ColumbiaGadgetWorks/radio-hardware/kicad/jlcpcb/BOM.csv

Comment | Designator | Footprint | LCSC Part # | MPN | Qty
22pF | C1,C2 | C_0603_1608Metric | C1653 | CL10C220JB8NNNC | 2
10uF | C13,C15,C16,C17,C18 | C_0603_1608Metric | C19702 | CL10A106KP8NNNC | 5
4.7uF | C3 | C_0603_1608Metric | C19666 | CL10A475KO8NNNC | 1
100nF | C4,C5,C6,C11,C14,C22 | C_0603_1608Metric | C14663 | CC0603KRX7R9BB104 | 6
22uF | C7,C21 | C_0603_1608Metric | C59461 | CL10A226MQ8NRNC | 2
1uF | C8,C10,C12,C19,C20 | C_0603_1608Metric | C15849 | CL10A105KB8NNNC | 5
1nF | C9 | C_0603_1608Metric | C1588 | CL10B102KB8NNNC | 1
B5819W | D1 | D_SOD-123 | C8598 | B5819W SL | 1
RED charging | D2 | LED_0603_1608Metric | C2286 | KT-0603R | 1
GREEN full | D3 | LED_0805_2012Metric | C2297 | KT-0805G | 1
0R (PTC spot) | F1 | Fuse_1206_3216Metric | C17888 | 1206W4F0000T5E | 1
USB-C 5V | J1 | USB_C_Receptacle_ShouHan_TYPE-C-6P-LTH6.8-108_Vertical | C30167335 | TYPE-C 6P LTH6.8 108 | 1
BATT PH2.0 | J2 | Battery_PH2.0_RightAngle_SMD_PlugCutout | C7429689 | ZX-PH2.0-WT2P | 1
56nH | L1 | L_0603_1608Metric | C98080 | LQW18AN56NJ00D | 1
AO3401A | Q1 | SOT-23 | C15127 | AO3401A | 1
100k | R1,R16,R17 | R_0603_1608Metric | C25803 | 0603WAF1003T5E | 3
5.1k | R11,R12 | R_0603_1608Metric | C23186 | 0603WAF5101T5E | 2
2.4k | R13 | R_0603_1608Metric | C22940 | 0603WAF2401T5E | 1
680R | R14 | R_0603_1608Metric | C23228 | 0603WAF6800T5E | 1
1k | R15,R18 | R_0603_1608Metric | C21190 | 0603WAF1001T5E | 2
51k | R2 | R_0603_1608Metric | C23196 | 0603WAF5102T5E | 1
4.7k | R22 | R_0603_1608Metric | C23162 | 0603WAF4701T5E | 1
0R (pin1 = -) | R23 | R_1206_3216Metric | C17888 | 1206W4F0000T5E | 1
0R (pin2 = +) | R24 | R_1206_3216Metric | C17888 | 1206W4F0000T5E | 1
10k | R3 | R_0603_1608Metric | C25804 | 0603WAF1002T5E | 1
100R | R4 | R_0603_1608Metric | C22775 | 0603WAF1000T5E | 1
330k | R5 | R_0603_1608Metric | C23137 | 0603WAF3303T5E | 1
68k | R6 | R_0603_1608Metric | C23231 | 0603WAF6802T5E | 1
47k | R7 | R_0603_1608Metric | C25819 | 0603WAF4702T5E | 1
680k | R8 | R_0603_1608Metric | C25822 | 0603WAF6803T5E | 1
0R | R9,R21 | R_0603_1608Metric | C21189 | 0603WAF0000T5E | 2
10k A + SW | RV1 | Potentiometer_CTR_R09512NS_RearMount_Switch | C18213422 | R09512NS-FB15S7.0-A103-00G | 1
Si4825-A10 | U1 | SOIC-16_3.9x9.9mm_P1.27mm | C2654605 | SI4825-A10-CSR | 1
NS8002 | U2 | SOIC-8-1EP_3.9x4.9mm_P1.27mm_EP2.41x3.3mm | C189960 | NS8002 | 1
TP4056 | U3 | SOIC-8-1EP_3.9x4.9mm_P1.27mm_EP2.29x3mm | C16581 | TP4056-42-ESOP8 | 1
XC6206P332MR | U4 | SOT-23 | C5446 | XC6206P332MR | 1
XB8089D | U6 | SOIC-8-1EP_3.9x4.9mm_P1.27mm_EP2.41x3.3mm | C79928 | XB8089D | 1
32.768kHz | Y1 | Crystal_SMD_3215-2Pin_3.2x1.5mm | C32346 | Q13FC13500004 | 1
