ColumbiaGadgetWorks/radio-hardware/kicad/scripts/circuit.py

"""The jar radio circuit: one place that defines every part and net.

gen_schematic.py turns this into the .kicad_sch, gen_pcb.py into the board,
and the BOM/CPL come from the same table, so they cannot drift apart.

Station: KOPN 89.5 MHz, set by R2/R3 (see the station divider note below) and
the silkscreen text.
"""
from schlib import SymDef

LIB = 'jar-radio'

R0603 = 'Resistor_SMD:R_0603_1608Metric'
C0603 = 'Capacitor_SMD:C_0603_1608Metric'
C0805 = 'Capacitor_SMD:C_0805_2012Metric'
L0603 = 'Inductor_SMD:L_0603_1608Metric'
SOT23 = 'Package_TO_SOT_SMD:SOT-23'
JR = 'jar-radio:'

# ---- symbol definitions -------------------------------------------------
SYMS = [
    SymDef('R', 'R', [('1', '~', 'T', 0), ('2', '~', 'B', 0)], two_pin=True),
    SymDef('C', 'C', [('1', '~', 'T', 0), ('2', '~', 'B', 0)], two_pin=True, body='cap'),
    SymDef('L', 'L', [('1', '~', 'T', 0), ('2', '~', 'B', 0)], two_pin=True),
    # diodes/LEDs: pin 1 = cathode (top), pin 2 = anode (bottom)
    SymDef('D', 'D', [('1', 'K', 'T', 0), ('2', 'A', 'B', 0)], two_pin=True, body='diode'),
    SymDef('LED', 'D', [('1', 'K', 'T', 0), ('2', 'A', 'B', 0)], two_pin=True, body='led'),
    SymDef('Si4825-A10', 'U', [
        ('1', 'LNA_EN', 'L', 0), ('2', 'TUNE1', 'L', 1), ('3', 'TUNE2', 'L', 2), ('4', 'BAND', 'L', 3),
        ('5', 'NC', 'L', 4), ('6', 'FMI', 'L', 5), ('7', 'RFGND', 'L', 6), ('8', 'AMI', 'L', 7),
        ('9', 'RST', 'R', 7), ('10', 'VOL+', 'R', 6), ('11', 'VOL-', 'R', 5), ('12', 'XTALO', 'R', 4),
        ('13', 'XTALI', 'R', 3), ('14', 'VDD', 'R', 2), ('15', 'GND', 'R', 1), ('16', 'AOUT', 'R', 0)], width=17.78),
    SymDef('NS8002', 'U', [
        ('1', 'SD', 'L', 0), ('2', 'BYPASS', 'L', 1), ('3', 'IN+', 'L', 2), ('4', 'IN-', 'L', 3),
        ('8', 'VO2', 'R', 0), ('7', 'GND', 'R', 1), ('6', 'VDD', 'R', 2), ('5', 'VO1', 'R', 3),
        ('9', 'EP', 'B', 1)], width=12.7),
    SymDef('TP4056', 'U', [
        ('1', 'TEMP', 'L', 0), ('2', 'PROG', 'L', 1), ('3', 'GND', 'L', 2), ('4', 'VCC', 'L', 3),
        ('8', 'CE', 'R', 0), ('7', 'CHRG', 'R', 1), ('6', 'STDBY', 'R', 2), ('5', 'BAT', 'R', 3),
        ('9', 'EP', 'B', 1)], width=12.7),
    SymDef('XC6206', 'U', [('3', 'VIN', 'L', 0), ('1', 'VSS', 'B', 1), ('2', 'VOUT', 'R', 0)]),
    SymDef('XC61CN', 'U', [('3', 'VIN', 'L', 0), ('2', 'VSS', 'B', 1), ('1', 'VOUT', 'R', 0)]),   # SOT-23 per Torex datasheet
    SymDef('AO3401A', 'Q', [('1', 'G', 'L', 1), ('3', 'D', 'L', 0), ('2', 'S', 'R', 0)]),
    SymDef('Pot_Switch', 'RV', [('3', 'CW', 'L', 0), ('2', 'WIPER', 'L', 1), ('1', 'CCW', 'L', 2),
                                ('S1', 'SW_A', 'R', 0), ('S2', 'SW_B', 'R', 1), ('MP', 'MOUNT', 'R', 2)], width=12.7),
    SymDef('USB_C_Power', 'J', [('2', 'VBUS', 'R', 0), ('5', 'VBUS', 'R', 1), ('3', 'CC1', 'R', 2), ('4', 'CC2', 'R', 3),
                                ('1', 'GND', 'R', 4), ('6', 'GND', 'R', 5), ('S', 'SHIELD', 'R', 6)], width=12.7),
    SymDef('Conn_2_MP', 'J', [('1', '1', 'R', 0), ('2', '2', 'R', 1), ('MP', 'MP', 'R', 2)]),
    SymDef('Conn_2', 'J', [('1', '1', 'R', 0), ('2', '2', 'R', 1)]),
    SymDef('Conn_1', 'J', [('1', '1', 'R', 0)]),
    SymDef('Pot3', 'RV', [('3', 'CW', 'L', 0), ('2', 'WIPER', 'L', 1), ('1', 'CCW', 'L', 2), ('MP', 'MOUNT', 'R', 0)], width=10.16),
    SymDef('XB8089D', 'U', [('6', 'VDD', 'L', 0), ('5', 'GND', 'L', 1), ('7', 'GND', 'L', 2), ('8', 'GND', 'L', 3),
                            ('1', 'VM', 'R', 0), ('2', 'VM', 'R', 1), ('3', 'VM', 'R', 2), ('4', 'VM', 'R', 3),
                            ('9', 'EP', 'B', 1)], width=12.7),
    SymDef('SW_SPDT', 'SW', [('1', 'A', 'L', 0), ('2', 'COM', 'R', 0), ('3', 'B', 'L', 1)]),
    SymDef('Trim_3', 'RV', [('1', 'TOP', 'R', 0), ('2', 'WIPER', 'R', 1), ('3', 'BOT', 'R', 2)]),
    SymDef('Crystal', 'Y', [('1', '1', 'T', 0), ('2', '2', 'B', 0)], two_pin=True),
]

# ---- parts ----------------------------------------------------------------
# (ref, symbol, value, footprint, LCSC, MPN, {pin: net}, extra)
# extra: dnp=True, hand=True (not assembled by JLC), block='...'
P = []


def part(ref, sym, value, fp, lcsc, mpn, nets, **kw):
    P.append(dict(ref=ref, sym=sym, value=value, footprint=fp, lcsc=lcsc, mpn=mpn, nets=nets, **kw))


# Tuner -------------------------------------------------------------------
B = 'tuner'
part('U1', 'Si4825-A10', 'Si4825-A10', 'Package_SO:SOIC-16_3.9x9.9mm_P1.27mm', 'C2654605', 'SI4825-A10-CSR',
     {'2': 'TUNE1', '3': 'TUNE2', '4': 'BAND', '6': 'FMI', '7': 'GND', '8': 'AMI', '9': 'RST',
      '10': 'GND', '11': 'GND', '12': 'XTALO', '13': 'XTALI', '14': '+3V3', '15': 'GND', '16': 'AOUT'},
     block=B, nc=('1', '5'))
part('Y1', 'Crystal', '32.768kHz', 'Crystal:Crystal_SMD_3215-2Pin_3.2x1.5mm', 'C32346', 'Q13FC13500004', {'1': 'XTALI', '2': 'XTALO'}, block=B)
part('C1', 'C', '22pF', C0603, 'C1653', 'CL10C220JB8NNNC', {'1': 'XTALI', '2': 'GND'}, block=B)
part('C2', 'C', '22pF', C0603, 'C1653', 'CL10C220JB8NNNC', {'1': 'XTALO', '2': 'GND'}, block=B)
part('C3', 'C', '4.7uF', C0603, 'C19666', 'CL10A475KO8NNNC', {'1': '+3V3', '2': 'GND'}, block=B)
part('C4', 'C', '100nF', C0603, 'C14663', 'CC0603KRX7R9BB104', {'1': '+3V3', '2': 'GND'}, block=B)
part('R1', 'R', '100k', R0603, 'C25803', '0603WAF1003T5E', {'1': '+3V3', '2': 'RST'}, block=B)
part('C5', 'C', '100nF', C0603, 'C14663', 'CC0603KRX7R9BB104', {'1': 'RST', '2': 'GND'}, block=B)
part('U5', 'XC61CN', 'XC61CN2702MR', SOT23, 'C112139', 'XC61CN2702MR-G', {'3': '+3V3', '2': 'GND', '1': 'RST'}, block=B, dnp=True)   # upgrade: brown-out reset
# station divider: TUNE1 -> R2 -> TUNE2 -> R3 -> TUNE_LO -> R4 -> GND
# ratio (R3+R4)/(R2+R3+R4) = 10.1/61.1 = 0.165. Measured on rev B (2026-11): KOPN plays
# for ratios 0.150-0.176, so 0.165 sits mid-window. The old 87 + 21*ratio law was wrong
# (it gave 82k/11k = 0.119 -> static). Both parts are Basic, 1%.
part('R2', 'R', '51k', R0603, 'C23196', '0603WAF5102T5E', {'1': 'TUNE1', '2': 'TUNE2'}, block=B, station=True)
part('R3', 'R', '10k', R0603, 'C25804', '0603WAF1002T5E', {'1': 'TUNE2', '2': 'TUNE_LO'}, block=B, station=True)
part('R4', 'R', '100R', R0603, 'C22775', '0603WAF1000T5E', {'1': 'TUNE_LO', '2': 'GND'}, block=B)
part('C6', 'C', '100nF', C0603, 'C14663', 'CC0603KRX7R9BB104', {'1': 'TUNE1', '2': 'GND'}, block=B)
part('C7', 'C', '22uF', C0603, 'C59461', 'CL10A226MQ8NRNC', {'1': 'TUNE1', '2': 'GND'}, block=B)
part('C21', 'C', '22uF', C0603, 'C59461', 'CL10A226MQ8NRNC', {'1': 'TUNE1', '2': 'GND'}, block=B)   # 2x22u = AN738's 47u
part('RV2', 'Trim_3', '100k CAL (DNP)', 'Connector_PinHeader_2.54mm:PinHeader_1x03_P2.54mm_Vertical', '', '3296W-1-104',
     {'1': 'TUNE1', '2': 'TUNE2', '3': 'TUNE_LO'}, block=B, dnp=True, hand=True)
# band ladder 330k + 100k + 68k = 498k (AN738: 500k +/-1%), all Basic parts
part('R5', 'R', '330k', R0603, 'C23137', '0603WAF3303T5E', {'1': 'TUNE1', '2': 'BAND_M'}, block=B)
part('R17', 'R', '100k', R0603, 'C25803', '0603WAF1003T5E', {'1': 'BAND_M', '2': 'BAND'}, block=B)
part('R6', 'R', '68k', R0603, 'C23231', '0603WAF6802T5E', {'1': 'BAND', '2': 'GND'}, block=B)
part('C8', 'C', '1uF', C0603, 'C15849', 'CL10A105KB8NNNC', {'1': 'AMI', '2': 'GND'}, block=B)
# antenna front end (AN738 5.2)
part('J3', 'Conn_1', 'ANT wire', JR + 'Antenna_Wire_Solder_D2.0', '', '', {'1': 'ANT'}, block='ant', nobom=True)   # wire soldered in by hand
part('ANT1', 'Conn_1', 'WHIP M3', JR + 'Antenna_Telescopic_M3', '', '', {'1': 'ANT'}, block='ant', hand=True, nobom=True)
part('D4', 'D', 'ESD 0.5pF', 'Diode_SMD:D_SOD-882', 'C126839', 'SP3021-01ETG', {'1': 'ANT', '2': 'GND'}, block='ant', dnp=True)   # upgrade: whip ESD
part('C9', 'C', '1nF', C0603, 'C1588', 'CL10B102KB8NNNC', {'1': 'ANT', '2': 'FMI'}, block='ant')   # Basic X7R; C0G C163508 is Extended
part('L1', 'L', '56nH', L0603, 'C98080', 'LQW18AN56NJ00D', {'1': 'FMI', '2': 'GND'}, block='ant')

# Audio -------------------------------------------------------------------
B = 'audio'
part('C10', 'C', '1uF', C0603, 'C15849', 'CL10A105KB8NNNC', {'1': 'AOUT', '2': 'AOUT_C'}, block=B)
# volume + power: CTR R09512NS, 9 mm rear-mount (shaft up) pot with rotary SPST switch, 10k audio
part('RV1', 'Pot_Switch', '10k A + SW', JR + 'Potentiometer_CTR_R09512NS_RearMount_Switch', 'C18213422',
     'R09512NS-FB15S7.0-A103-00G', {'3': 'VOL_TOP', '2': 'VOL_WIPER', '1': 'GND', 'S1': 'VSYS', 'S2': 'VSW', 'MP': 'GND'}, block=B)
# R22 keeps the Si4825 AOUT load >= 10k with the 10k pot (4.7k + 10k||47k = 12.9k)
part('R22', 'R', '4.7k', R0603, 'C23162', '0603WAF4701T5E', {'1': 'AOUT_C', '2': 'VOL_TOP'}, block=B)
part('C11', 'C', '100nF', C0603, 'C14663', 'CC0603KRX7R9BB104', {'1': 'VOL_WIPER', '2': 'AMP_C'}, block=B)   # 100n x 47k = 34 Hz
part('R7', 'R', '47k', R0603, 'C25819', '0603WAF4702T5E', {'1': 'AMP_C', '2': 'AMP_INN'}, block=B)   # Ri; with R22 the Si4825 sees >= 12.9k
part('R8', 'R', '680k', R0603, 'C25822', '0603WAF6803T5E', {'1': 'AMP_INN', '2': 'SPK+'}, block=B)   # Av = 2*680/47 = 29, makes up R22's ~4 dB
part('U2', 'NS8002', 'NS8002', 'Package_SO:SOIC-8-1EP_3.9x4.9mm_P1.27mm_EP2.41x3.3mm', 'C189960', 'NS8002',
     {'1': 'AMP_SD', '2': 'AMP_BYP', '3': 'AMP_BYP', '4': 'AMP_INN', '5': 'SPK+', '6': 'VSW', '7': 'GND', '8': 'SPK-', '9': 'GND'}, block=B)
part('C12', 'C', '1uF', C0603, 'C15849', 'CL10A105KB8NNNC', {'1': 'AMP_BYP', '2': 'GND'}, block=B)
part('C13', 'C', '10uF', C0603, 'C19702', 'CL10A106KP8NNNC', {'1': 'VSW', '2': 'GND'}, block=B)
part('C14', 'C', '100nF', C0603, 'C14663', 'CC0603KRX7R9BB104', {'1': 'VSW', '2': 'GND'}, block=B)
part('R9', 'R', '0R', R0603, 'C21189', '0603WAF0000T5E', {'1': 'AMP_SD', '2': 'GND'}, block=B)
part('R10', 'R', '0R (DNP)', R0603, 'C21189', '0603WAF0000T5E', {'1': 'AMP_SD', '2': 'VSW'}, block=B, dnp=True)
part('J4', 'Conn_2', 'SPEAKER', JR + 'Speaker_HDK-4008BB-2_TopMount', '', 'HDK-4008BB-2 (C22371323, hand-soldered by its tabs)', {'1': 'SPK+', '2': 'SPK-'}, block=B, hand=True, nobom=True)   # polarity is irrelevant for one speaker

# Power -------------------------------------------------------------------
B = 'power'
part('J1', 'USB_C_Power', 'USB-C 5V', JR + 'USB_C_Receptacle_ShouHan_TYPE-C-6P-LTH6.8-108_Vertical', 'C30167335', 'TYPE-C 6P LTH6.8 108',
     {'2': 'VBUS', '5': 'VBUS', '3': 'CC1', '4': 'CC2', '1': 'GND', '6': 'GND', 'S': 'GND'}, block=B, top=True)
part('R11', 'R', '5.1k', R0603, 'C23186', '0603WAF5101T5E', {'1': 'CC1', '2': 'GND'}, block=B)
part('R12', 'R', '5.1k', R0603, 'C23186', '0603WAF5101T5E', {'1': 'CC2', '2': 'GND'}, block=B)
part('C15', 'C', '10uF', C0603, 'C19702', 'CL10A106KP8NNNC', {'1': 'VBUS', '2': 'GND'}, block=B)
part('U3', 'TP4056', 'TP4056', 'Package_SO:SOIC-8-1EP_3.9x4.9mm_P1.27mm_EP2.29x3mm', 'C16581', 'TP4056-42-ESOP8',
     {'1': 'TEMP', '2': 'PROG', '3': 'GND', '4': 'VBUS', '5': 'VBAT', '6': 'STDBY', '7': 'CHRG', '8': 'VBUS', '9': 'GND'}, block=B)
# TEMP: R21 0R to GND disables the battery-temperature check. Upgrade: remove R21,
# fit R20 5.1k + RT1 10k B3950 NTC (charging allowed ~10-46 C on the board)
part('R21', 'R', '0R', R0603, 'C21189', '0603WAF0000T5E', {'1': 'TEMP', '2': 'GND'}, block=B)
part('R20', 'R', '5.1k (DNP)', R0603, 'C23186', '0603WAF5101T5E', {'1': 'VBUS', '2': 'TEMP'}, block=B, dnp=True)
part('RT1', 'R', 'NTC 10k B3950 (DNP)', R0603, 'C279936', 'SDNT1608X103F3950FTF', {'1': 'TEMP', '2': 'GND'}, block=B, dnp=True)
part('R13', 'R', '2.4k', R0603, 'C22940', '0603WAF2401T5E', {'1': 'PROG', '2': 'GND'}, block=B)
part('D2', 'LED', 'RED charging', 'LED_SMD:LED_0603_1608Metric', 'C2286', 'KT-0603R',
     {'1': 'CHRG', '2': 'LEDR_A'}, block=B)
part('R14', 'R', '680R', R0603, 'C23228', '0603WAF6800T5E', {'1': 'VBUS', '2': 'LEDR_A'}, block=B)
part('D3', 'LED', 'GREEN full', 'LED_SMD:LED_0805_2012Metric', 'C2297', 'KT-0805G',
     {'1': 'STDBY', '2': 'LEDG_A'}, block=B)
part('R15', 'R', '1k', R0603, 'C21190', '0603WAF1001T5E', {'1': 'VBUS', '2': 'LEDG_A'}, block=B)
part('C16', 'C', '10uF', C0603, 'C19702', 'CL10A106KP8NNNC', {'1': 'VBAT', '2': 'GND'}, block=B)
# battery: 102050 LiPo (1000 mAh, own PCM) on a JST-PH 2.0 plug. Clone PH plugs have no
# standard polarity, so check each batch: red must land on the '+' pin (pad 2).
# The XB8089D below also survives a reversed cell.
part('J2', 'Conn_2_MP', 'BATT PH2.0', JR + 'Battery_PH2.0_RightAngle_SMD_PlugCutout', 'C7429689', 'ZX-PH2.0-WT2P',
     {'1': 'BATJ1', '2': 'BATJ2', 'MP': 'GND'}, block=B, top=True)
# polarity crossover, 1206 0R (same part as F1, easy to move by hand). Fit R23+R24
# (pin 2 = +) OR R25+R26 (pin 1 = +), never both pairs: that shorts the cell.
part('R23', 'R', '0R (pin1 = -)', 'Resistor_SMD:R_1206_3216Metric', 'C17888', '1206W4F0000T5E', {'1': 'BATJ1', '2': 'BAT_N'}, block=B)
part('R24', 'R', '0R (pin2 = +)', 'Resistor_SMD:R_1206_3216Metric', 'C17888', '1206W4F0000T5E', {'1': 'BATJ2', '2': 'BAT_P'}, block=B)
part('R25', 'R', '0R (DNP, pin1 = +)', 'Resistor_SMD:R_1206_3216Metric', 'C17888', '1206W4F0000T5E', {'1': 'BATJ1', '2': 'BAT_P'}, block=B, dnp=True)
part('R26', 'R', '0R (DNP, pin2 = -)', 'Resistor_SMD:R_1206_3216Metric', 'C17888', '1206W4F0000T5E', {'1': 'BATJ2', '2': 'BAT_N'}, block=B, dnp=True)
# protection: PTC in BAT+, XB8089D (OV 4.25 / UV 2.5 V, 10 A OC, 40 A short, reverse cell) in BAT-
# F1 is fitted with a 0R 1206 jumper; upgrade = PTC SMD1206B110TFT (C269119) on the same pads
part('F1', 'R', '0R (PTC spot)', 'Fuse:Fuse_1206_3216Metric', 'C17888', '1206W4F0000T5E', {'1': 'BAT_P', '2': 'VBAT'}, block=B)
part('U6', 'XB8089D', 'XB8089D', 'Package_SO:SOIC-8-1EP_3.9x4.9mm_P1.27mm_EP2.41x3.3mm', 'C79928', 'XB8089D',
     {'6': 'XB_VDD', '5': 'BAT_N', '7': 'BAT_N', '8': 'BAT_N', '9': 'BAT_N', '1': 'GND', '2': 'GND', '3': 'GND', '4': 'GND'}, block=B)
part('R18', 'R', '1k', R0603, 'C21190', '0603WAF1001T5E', {'1': 'BAT_P', '2': 'XB_VDD'}, block=B)
part('C22', 'C', '100nF', C0603, 'C14663', 'CC0603KRX7R9BB104', {'1': 'XB_VDD', '2': 'BAT_N'}, block=B)
part('Q1', 'AO3401A', 'AO3401A', SOT23, 'C15127', 'AO3401A', {'1': 'VBUS', '2': 'VSYS', '3': 'VBAT'}, block=B)
part('R16', 'R', '100k', R0603, 'C25803', '0603WAF1003T5E', {'1': 'VBUS', '2': 'GND'}, block=B)
part('D1', 'D', 'B5819W', 'Diode_SMD:D_SOD-123', 'C8598', 'B5819W SL', {'1': 'VSYS', '2': 'VBUS'}, block=B)
part('C17', 'C', '10uF', C0603, 'C19702', 'CL10A106KP8NNNC', {'1': 'VSYS', '2': 'GND'}, block=B)
part('C18', 'C', '10uF', C0603, 'C19702', 'CL10A106KP8NNNC', {'1': 'VSW', '2': 'GND'}, block=B)
part('U4', 'XC6206', 'XC6206P332MR', SOT23, 'C5446', 'XC6206P332MR', {'3': 'VSW', '1': 'GND', '2': '+3V3'}, block=B)
part('C19', 'C', '1uF', C0603, 'C15849', 'CL10A105KB8NNNC', {'1': 'VSW', '2': 'GND'}, block=B)
part('C20', 'C', '1uF', C0603, 'C15849', 'CL10A105KB8NNNC', {'1': '+3V3', '2': 'GND'}, block=B)

SYM_BY_NAME = {s.name: s for s in SYMS}
