ColumbiaGadgetWorks/radio-hardware/(notices)

Notices in the files:
kicad/jar-radio.kicad_sch:
Hardware licence: CERN-OHL-S-2.0
kicad/jar-radio.kicad_pcb:
CERN-OHL-S-2.0
